IdleHandsProject/Sensory_Adaptation_Bot/Docs/Motor_Controll_ANN_Run.pdf

# ANNMotorControl

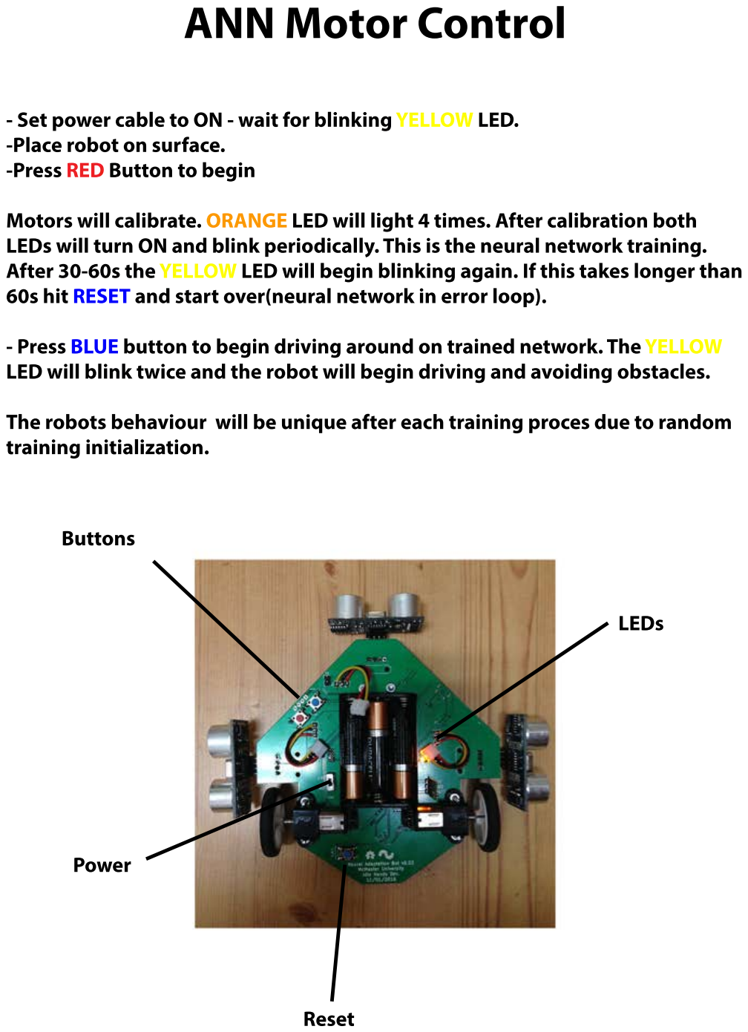
[picture p1: page 1]

-SetpowercabletoON-waitforblinkingYELLOWLED. -Placerobotonsurface.
-PressREDButtontobegin

Motorswillcalibrate.ORANGELEDwilllight4times.Aftercalibrationboth LEDswillturnONandblinkperiodically.Thisistheneuralnetworktraining. After30-60stheYELLOWLEDwillbeginblinkingagain.Ifthistakeslongerthan 60shitRESETandstartover(neuralnetworkinerrorloop).

-PressBLUEbuttontobegindrivingaroundontrainednetwork.TheYELLOW LEDwillblinktwiceandtherobotwillbegindrivingandavoidingobstacles.

Therobotsbehaviourwillbeuniqueaftereachtrainingprocesduetorandom traininginitialization.

Buttons

LEDs

Power

Reset
