IdleHandsProject/Sensory_Adaptation_Bot/CAD/Long Range SHARP IR Sensors - #GP2Y0A21YK0F.STEP

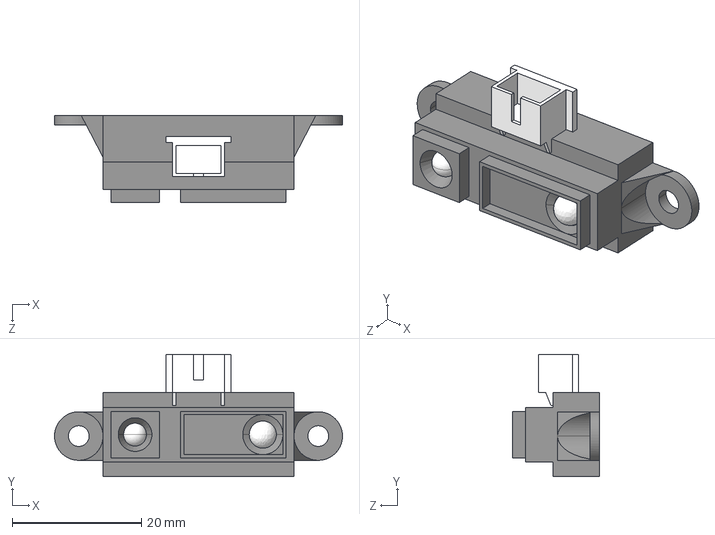
[picture p2: CAD file, 2016-05-12]
CAD/Long Range SHARP IR Sensors - #GP2Y0A21YK0F.STEP
44.5 x 18.9 x 13.5 mm
