IdleHandsProject/Sensory_Adaptation_Bot/CAD/SharpIR_Stand.stl

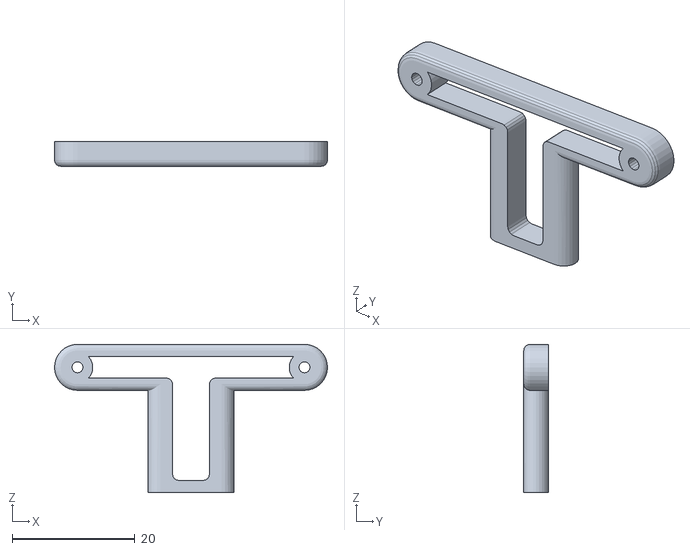
[picture p3: CAD file, 2016-05-12]
CAD/SharpIR_Stand.stl
44.5 x 4.00 x 24.2
