IdleHandsProject/Sensory_Adaptation_Bot/(list of files, cad)

Other CAD files:
CAD/Long Range SHARP IR Sensors - #GP2Y0A21YK0F.CATPart
CAD/SharpIRStand.CATProduct
CAD/Stand.CATPart
