IdleHandsProject/Sensory_Adaptation_Bot/(threads)

Thread 3 (2016-05-12):

Need to add reset button.

hodginsa, 2016-05-12:

hodginsa, 2016-07-15:
Reset Added On top

Closed 2016-07-15.

Thread 4 (2016-05-12):

Incorrect Interrupt Pin

hodginsa, 2016-05-12:
Each of the motors share an interrupt(INT2) - either AENC2 or BENC1 needs to change pins to gain full encoder speed.

hodginsa, 2016-07-15:
Moved BENC1 from INT2(PA18) to INT1(PA17)

Closed 2016-07-15.

Thread 5 (2016-05-18):

Move Motor A PWM pin from SWCLK

hodginsa, 2016-05-18:
One of the motor pins is an automatic PWM at start up which makes the motor activate for a few seconds, switching this pin with the interrupt could solve the problem.

hodginsa, 2016-07-16:
Moved motor to "A0"

Closed 2016-07-16.

Thread 8 (2016-12-03):

A0 cannot be PWM'd

hodginsa, 2016-12-03:
Switch A0(PA02) pin for AIN2 to D5(PA15) so it can be properly PWM.
This frees up an Analog channel to read battery voltage.

Thread 9 (2016-12-03):

SD Card not reading.

hodginsa, 2016-12-03:
Not sure the issue. SPI lines seem correct. Card was able to be read only once. Possible firmware/Arduino Issue.

Card not being detected.
