IdleHandsProject/Sensory_Adaptation_Bot/sa_bot.kicad_pcb

## KiCad design sa_bot.kicad_pcb (2016-12-03)

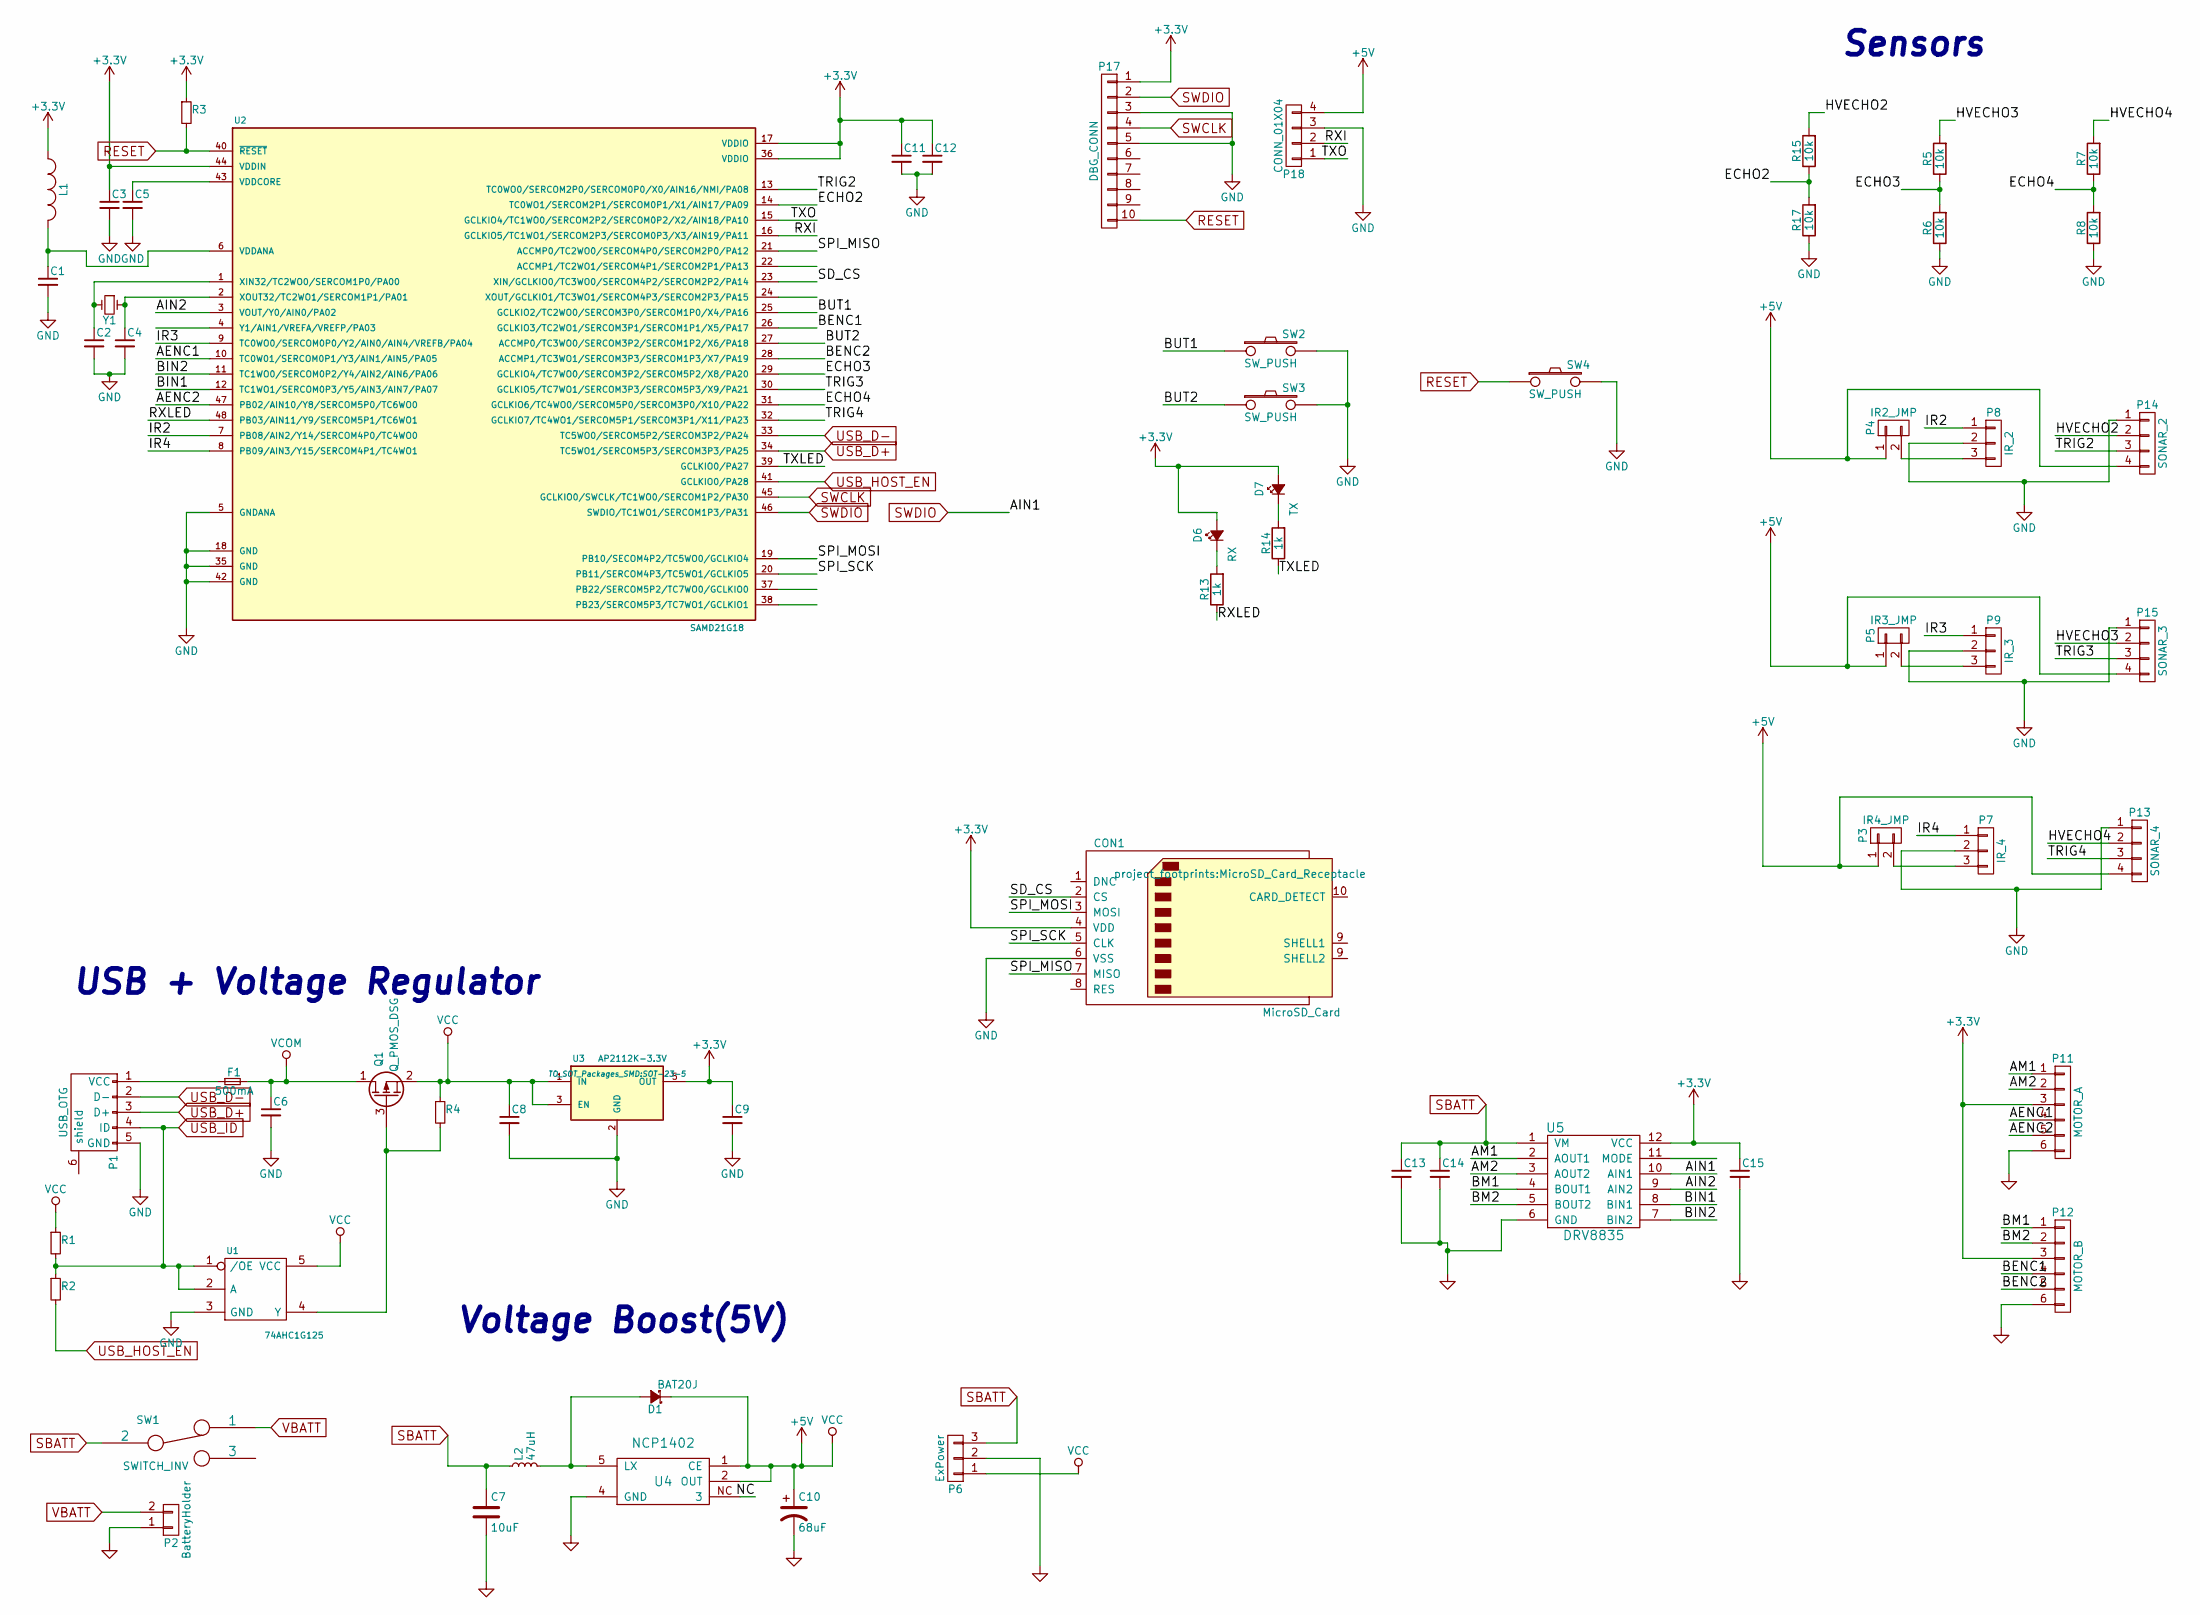
[picture p4: schematic sa_bot.sch]

Parts:
C1, C3, C5, C11, C12, C14, C15: 0.1uF; C_0402_Hand; Digikey Part No. 490-6328-1-ND
C2, C4: 15pF; C_0402_Hand; Digikey Part No. 712-1261-1-ND
C6: 2.2uF; C_0402_Hand; Digikey Part No. 1276-1291-1-ND
C7: 10uF; C_0402_Hand; Digikey Part No. 311-1376-1-ND
C8: 1uF; C_0402_Hand; Digikey Part No. 490-4516-1-ND
C9: 2.2uF; C_0402_Hand; Digikey Part No. 587-1059-1-ND
C10: 68uF; C_0402_Hand; Digikey Part No. P16816-1-ND
C13: 10uF; C_0402_Hand; Digikey Part No. 311-1729-1-ND
CON1: MicroSD_Card; MicroSD_Card_Receptacle; Digikey Part No. 114-00841-68-2-ND
D1: BAT20J; sod80c; Digikey Part No. 497-3381-1-ND
D6: RX; Led_0603; Digikey Part No. 160-1447-1-ND
D7: TX; Led_0603; Digikey Part No. 160-1448-1-ND
F1: 500mA; c_1206; Digikey Part No. 507-1803-1-ND
L1: FB - 30Ohm; R_SM0603; Digikey Part No. 445-2986-1-ND
L2: 47uH; I_1212; Digikey Part No. 587-2104-1-ND
P1: USB_OTG; USB_Micro-B; Digikey Part No. 609-4618-1-ND
P2: BatteryHolder; Battery_3xAAA_Holder; Digikey Part No. 36-2479-ND
P3: IR4_JMP; Pin_Header_Straight_1x02
P4: IR2_JMP; Pin_Header_Straight_1x02
P5: IR3_JMP; Pin_Header_Straight_1x02
P6: ExPower; Pin_Header_Straight_1x03
P7: IR_4; Pin_Header_Straight_1x03
P8: IR_2; Pin_Header_Straight_1x03
P9: IR_3; Pin_Header_Straight_1x03
P11: MOTOR_A; Pin_Header_Straight_1x06
P12: MOTOR_B; Pin_Header_Straight_1x06
P13: SONAR_4; Pin_Header_Straight_1x04; Digikey Part No. S5479-ND
P14: SONAR_2; Pin_Header_Straight_1x04; Digikey Part No. S5479-ND
P15: SONAR_3; Pin_Header_Straight_1x04; Digikey Part No. S5479-ND
P17: DBG_CONN; Pin_Header_Straight_2x05_Pitch1.27mm; Digikey Part No. 1175-1627-ND
P18: CONN_01X04; Pin_Header_Straight_1x04
Q1: Q_PMOS_DSG; SOT23; Digikey Part No. DMG2307L-7DICT-ND
R1: 100k; R_0402_Hand; Digikey Part No. 311-100KLRCT-ND
R2: 330; R_0402_Hand; Digikey Part No. 311-330JRCT-ND
R3, R5, R6, R7, R8, R15, R17: 10k; R_0402_Hand; Digikey Part No. 311-10KJRCT-ND
R4: 47K; R_0402_Hand; Digikey Part No. 311-47.0KLRCT-ND
R13, R14: 1k; R_0402_Hand; Digikey Part No. 311-1.0KJRCT-ND
SW1: SWITCH_INV; Pin_Header_Straight_1x03
SW2: SW_PUSH; SW_SPST_PTS645; Digikey Part No. CKN9112CT-ND
SW3: SW_PUSH; SW_SPST_PTS645; Digikey Part No. CKN9084CT-ND
SW4: SW_PUSH; SW_SPST_EVQPE1; Digikey Part No. CKN9084CT-ND
U1: 74AHC1G125; sot23-5; Digikey Part No. 568-4452-1-ND
U2: SAMD21G18; TQFP-48_7x7mm_Pitch0.5mm; Digikey Part No. ATSAMD21G18A-AU-ND
U3: AP2112K-3.3V; SOT-23-5; Digikey Part No. AP2112K-3.3TRG1DICT-ND
U4: NCP1402; sot23-5
U5: DRV8835; WSON-12-2x3; Digikey Part No. 296-30391-1-ND
Y1: Crystal_Small; crystal_smd_5x3.2mm; Digikey Part No. 535-9536-1-ND

Connections:
+3V3: C3.1, C9.1, C11.1, C12.1, C15.1, CON1.4 (VDD), D6.2 (A), D7.2 (A), L1.1, P11.3, P12.3, P17.1, R3.1, U2.17 (VDDIO), U2.36 (VDDIO), U2.44 (VDDIN), U3.5 (OUT), U5.12 (VCC)
/AENC1: P11.4, U2.10 (TC0W01/SERCOM0P1/Y3/AIN1/AIN5/PA05)
/AENC2: P11.5, U2.47 (PB02/AIN10/Y8/SERCOM5P0/TC6WO0)
/AIN2: U2.3 (VOUT/Y0/AIN0/PA02), U5.9 (AIN2)
/AM1: P11.1, U5.2 (AOUT1)
/AM2: P11.2, U5.3 (AOUT2)
/BENC1: P12.4, U2.26 (GCLKIO3/TC2WO1/SERCOM3P1/SERCOM1P1/X5/P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)
/BENC2: P12.5, U2.28 (ACCMP1/TC3WO1/SERCOM3P3/SERCOM1P3/X7/PA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)
/BIN1: U2.12 (TC1WO1/SERCOM0P3/Y5/AIN3/AIN7/PA07), U5.8 (BIN1)
/BIN2: U2.11 (TC1WO0/SERCOM0P2/Y4/AIN2/AIN6/PA06), U5.7 (BIN2)
/BM1: P12.1, U5.4 (BOUT1)
/BM2: P12.2, U5.5 (BOUT2)
/BUT1: SW2.1, U2.25 (GCLKIO2/TC2WO0/SERCOM3P0/SERCOM1P0/X4/P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)
/BUT2: SW3.1, U2.27 (ACCMP0/TC3WO0/SERCOM3P2/SERCOM1P2/X6/PA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)
/ECHO2: R15.1, R17.2, U2.14 (TC0WO1/SERCOM2P1/SERCOM0P1/X1/AIN17/PA09)
/ECHO3: R5.1, R6.2, U2.29 (GCLKIO4/TC7WO0/SERCOM3P2/SERCOM5P2/X8/P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)
/ECHO4: R7.1, R8.2, U2.31 (GCLKIO6/TC4WO0/SERCOM5P0/SERCOM3P0/X10/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)
/HVECHO2: P14.2, R15.2
/HVECHO3: P15.2, R5.2
/HVECHO4: P13.2, R7.2
/IR2: P8.1, U2.7 (PB08/AIN2/Y14/SERCOM4P0/TC4WO0)
/IR3: P9.1, U2.9 (TC0WO0/SERCOM0P0/Y2/AIN0/AIN4/VREFB/PA04)
/IR4: P7.1, U2.8 (PB09/AIN3/Y15/SERCOM4P1/TC4WO1)
/RXI: P18.2, U2.16 (GCLKIO5/TC1WO1/SERCOM2P3/SERCOM0P3/X3/A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)
/RXLED: R13.1, U2.48 (PB03/AIN11/Y9/SERCOM5P1/TC6WO1)
/SD_CS: CON1.2 (CS), U2.23 (XIN/GCLKIO0/TC3WO0/SERCOM4P2/SERCOM2P2/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)
/SPI_MISO: CON1.7 (MISO), U2.21 (ACCMP0/TC2WO0/SERCOM4P0/SERCOM2P0/PA12)
/SPI_MOSI: CON1.3 (MOSI), U2.19 (PB10/SECOM4P2/TC5WO0/GCLKIO4)
/SPI_SCK: CON1.5 (CLK), U2.20 (PB11/SERCOM4P3/TC5WO1/GCLKIO5)
/TRIG2: P14.3, U2.13 (TC0WO0/SERCOM2P0/SERCOM0P0/X0/AIN16/NMI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)
/TRIG3: P15.3, U2.30 (GCLKIO5/TC7WO1/SERCOM3P3/SERCOM5P3/X9/P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)
/TRIG4: P13.3, U2.32 (GCLKIO7/TC4WO1/SERCOM5P1/SERCOM3P1/X11/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)
/TXLED: R14.1, U2.39 (GCLKIO0/PA27)
/TXO: P18.1, U2.15 (GCLKIO4/TC1WO0/SERCOM2P2/SERCOM0P2/X2/A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)
GND: C1.2, C2.2, C3.2, C4.2, C5.2, C6.2, C7.2, C8.2, C9.2, C10.2, C11.2, C12.2, C13.2, C14.2, C15.2, CON1.6 (VSS), P1.5 (GND), P2.1, P6.2, P7.2, P8.2, P9.2, P11.6, P12.6, P13.1, P14.1, P15.1, P17.3, P17.5, P18.3, R6.1, R8.1, R17.1, SW2.2, SW3.2, SW4.2, U1.3 (GND), U2.5 (GNDANA), U2.18 (GND), U2.35 (GND), U2.42 (GND), U3.2 (GND), U4.4 (GND), U5.6 (GND)
unnamed: C1.1, L1.2, U2.6 (VDDANA)
unnamed: C2.1, U2.1 (XIN32/TC2WO0/SERCOM1P0/PA00), Y1.2
unnamed: C4.1, U2.2 (XOUT32/TC2WO1/SERCOM1P1/PA01), Y1.1
unnamed: C5.1, U2.43 (VDDCORE)
unnamed: D1.2 (A), L2.2, U4.5 (LX)
unnamed: D6.1 (K), R13.2
unnamed: D7.1 (K), R14.2
unnamed: F1.1, P1.1 (VCC)
unnamed: P3.2, P7.3
unnamed: P4.2, P8.3
unnamed: P5.2, P9.3
unnamed: Q1.3 (G), R4.2, U1.4 (Y)
RESET: P17.10, R3.2, SW4.1, U2.40 (~RESET~)
SBATT: C7.1, C13.1, C14.1, L2.1, P6.3, SW1.2, U5.1 (VM)
SWCLK: P17.4, U2.45 (GCLKIO0/SWCLK/TC1WO0/SERCOM1P2/PA30)
SWDIO: P17.2, U2.46 (SWDIO/TC1WO1/SERCOM1P3/PA31), U5.10 (AIN1)
USB_D+: P1.3 (D+), U2.34 (TC5WO1/SERCOM5P3/SERCOM3P3/PA25)
USB_D-: P1.2 (D-), U2.33 (TC5WO0/SERCOM5P2/SERCOM3P2/PA24)
USB_HOST_EN: R2.2, U2.41 (GCLKIO0/PA28)
USB_ID: P1.4 (ID), R1.2, R2.1, U1.1 (/OE), U1.2 (A)
VBATT: P2.2, SW1.1
VCC: C8.1, C10.1, D1.1 (K), P3.1, P4.1, P5.1, P6.1, P13.4, P14.4, P15.4, P18.4, Q1.2 (S), R1.1, R4.1, U1.5 (VCC), U3.1 (IN), U3.3 (EN), U4.1 (CE), U4.2 (OUT)
VCOM: C6.1, F1.2, Q1.1 (D)

Notes on the sheet:
USB + Voltage Regulator
Voltage Boost(5V)
Sensors

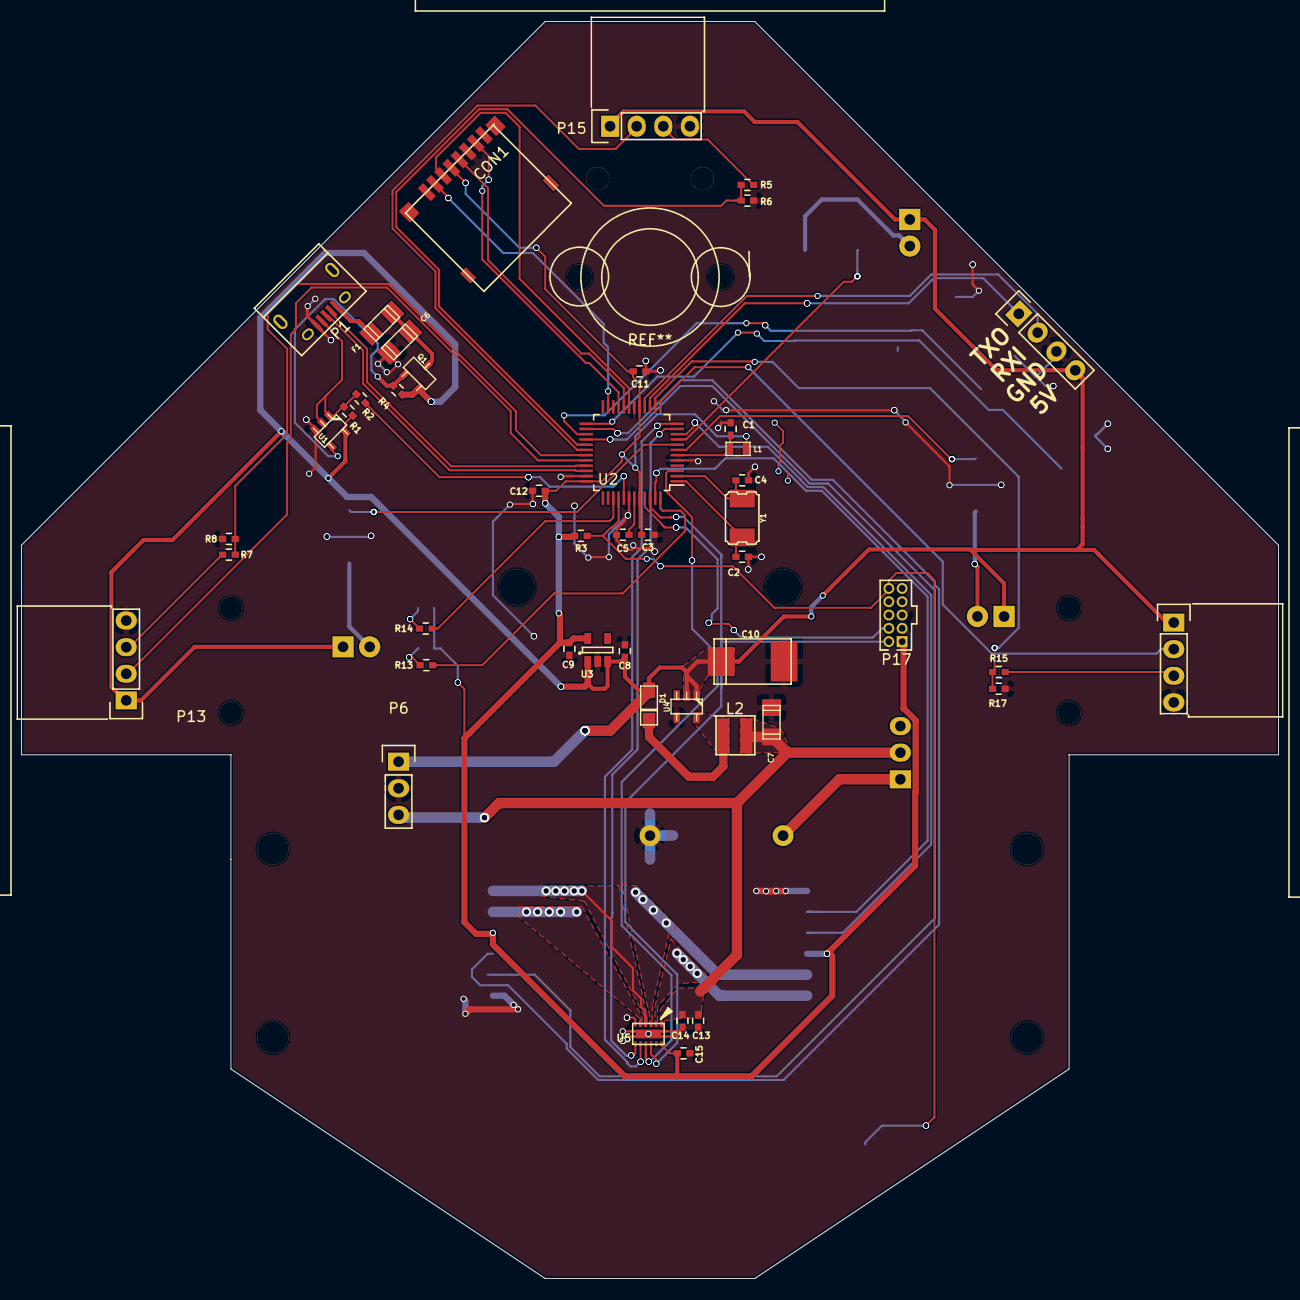
[picture p5: board sa_bot.kicad_pcb from above]

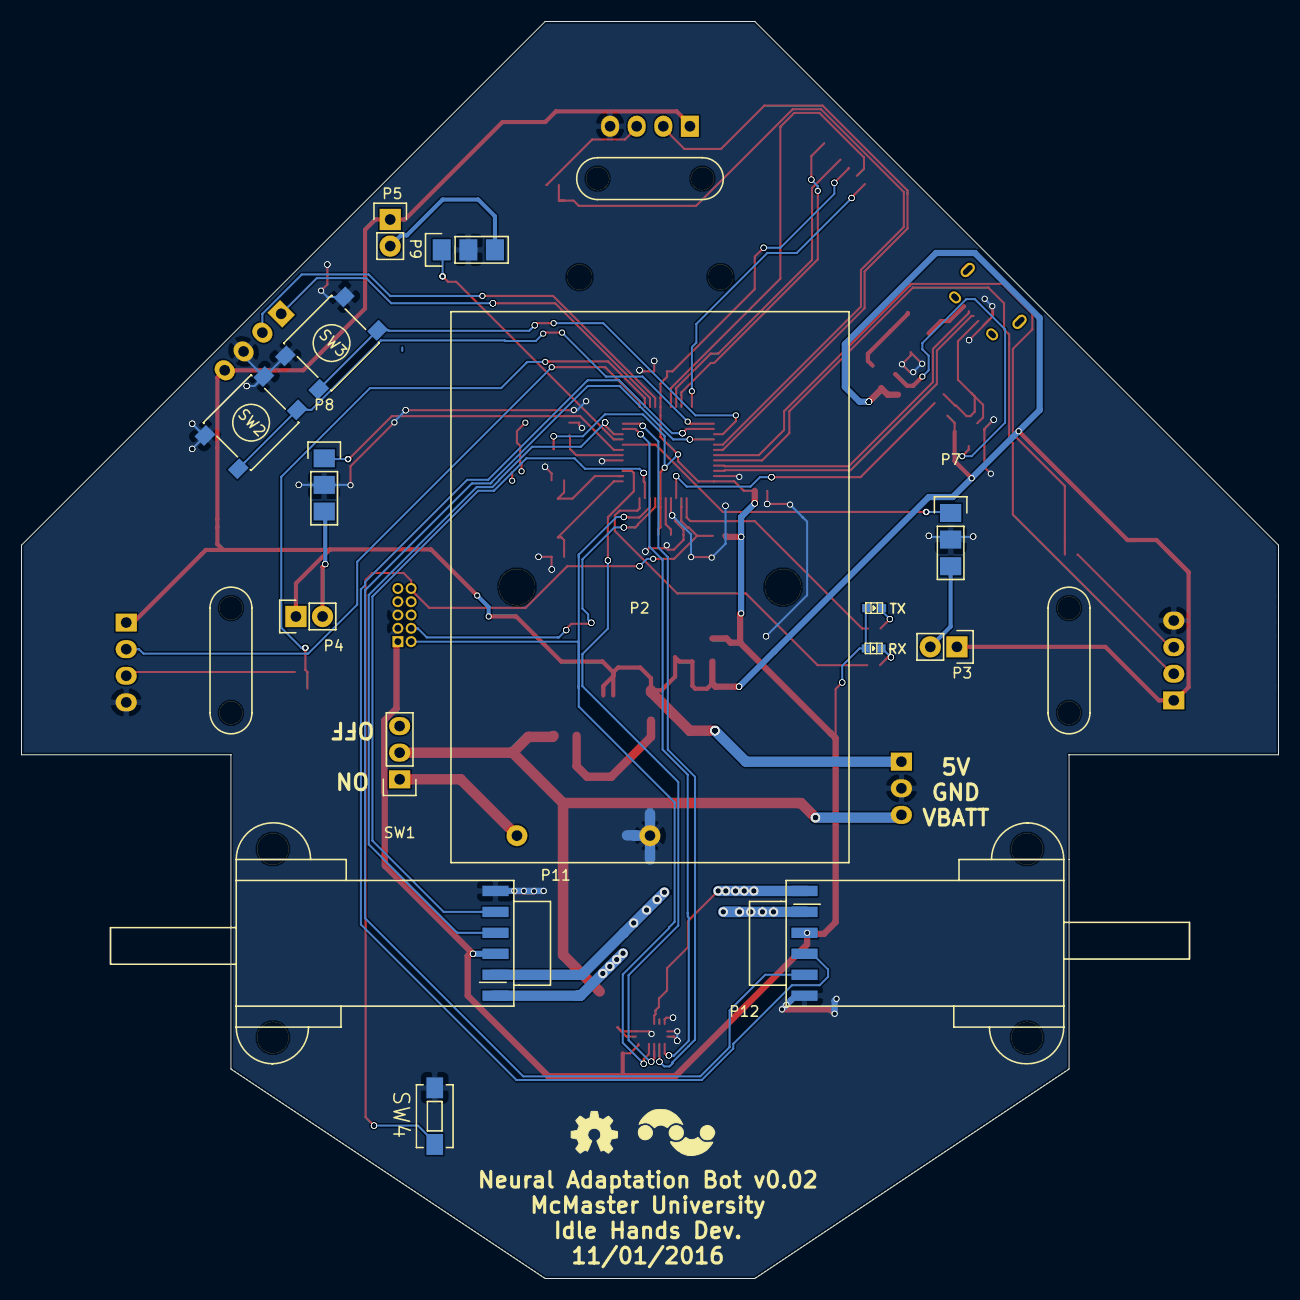
[picture p6: board sa_bot.kicad_pcb from below]

Board: 2 copper layers, 120.0 x 120.0 mm, 61 parts (15 on the bottom side), 58 nets.
