IdleHandsProject/Sensory_Adaptation_Bot/(commit log)

2016-07-15 Moved RXTX LEDs
    [sa_bot.kicad_pcb, sa_bot.sch]
2016-07-15 Added Reset Button
    [sa_bot.kicad_pcb, sa_bot.sch]
2016-07-15 Fixed encoder Interrupt
    [sa_bot.kicad_pcb, sa_bot.sch]
2016-07-16 Moved Motor from SWCLK to A0
    [sa_bot.kicad_pcb, sa_bot.sch]
2016-12-03 V002 and firmware
    [sa_bot-B.Cu.gbr, sa_bot-B.Mask.gbr, sa_bot-B.SilkS.gbr, sa_bot-Edge.Cuts.gbr, sa_bot-F.Cu.gbr, sa_bot-F.Mask.gbr, sa_bot-F.SilkS.gbr, sa_bot.drl]
